jungGT/rgbtime/hardware/rgbtime.kicad_pcb

## KiCad design hardware/rgbtime.kicad_pcb (2015-07-12)

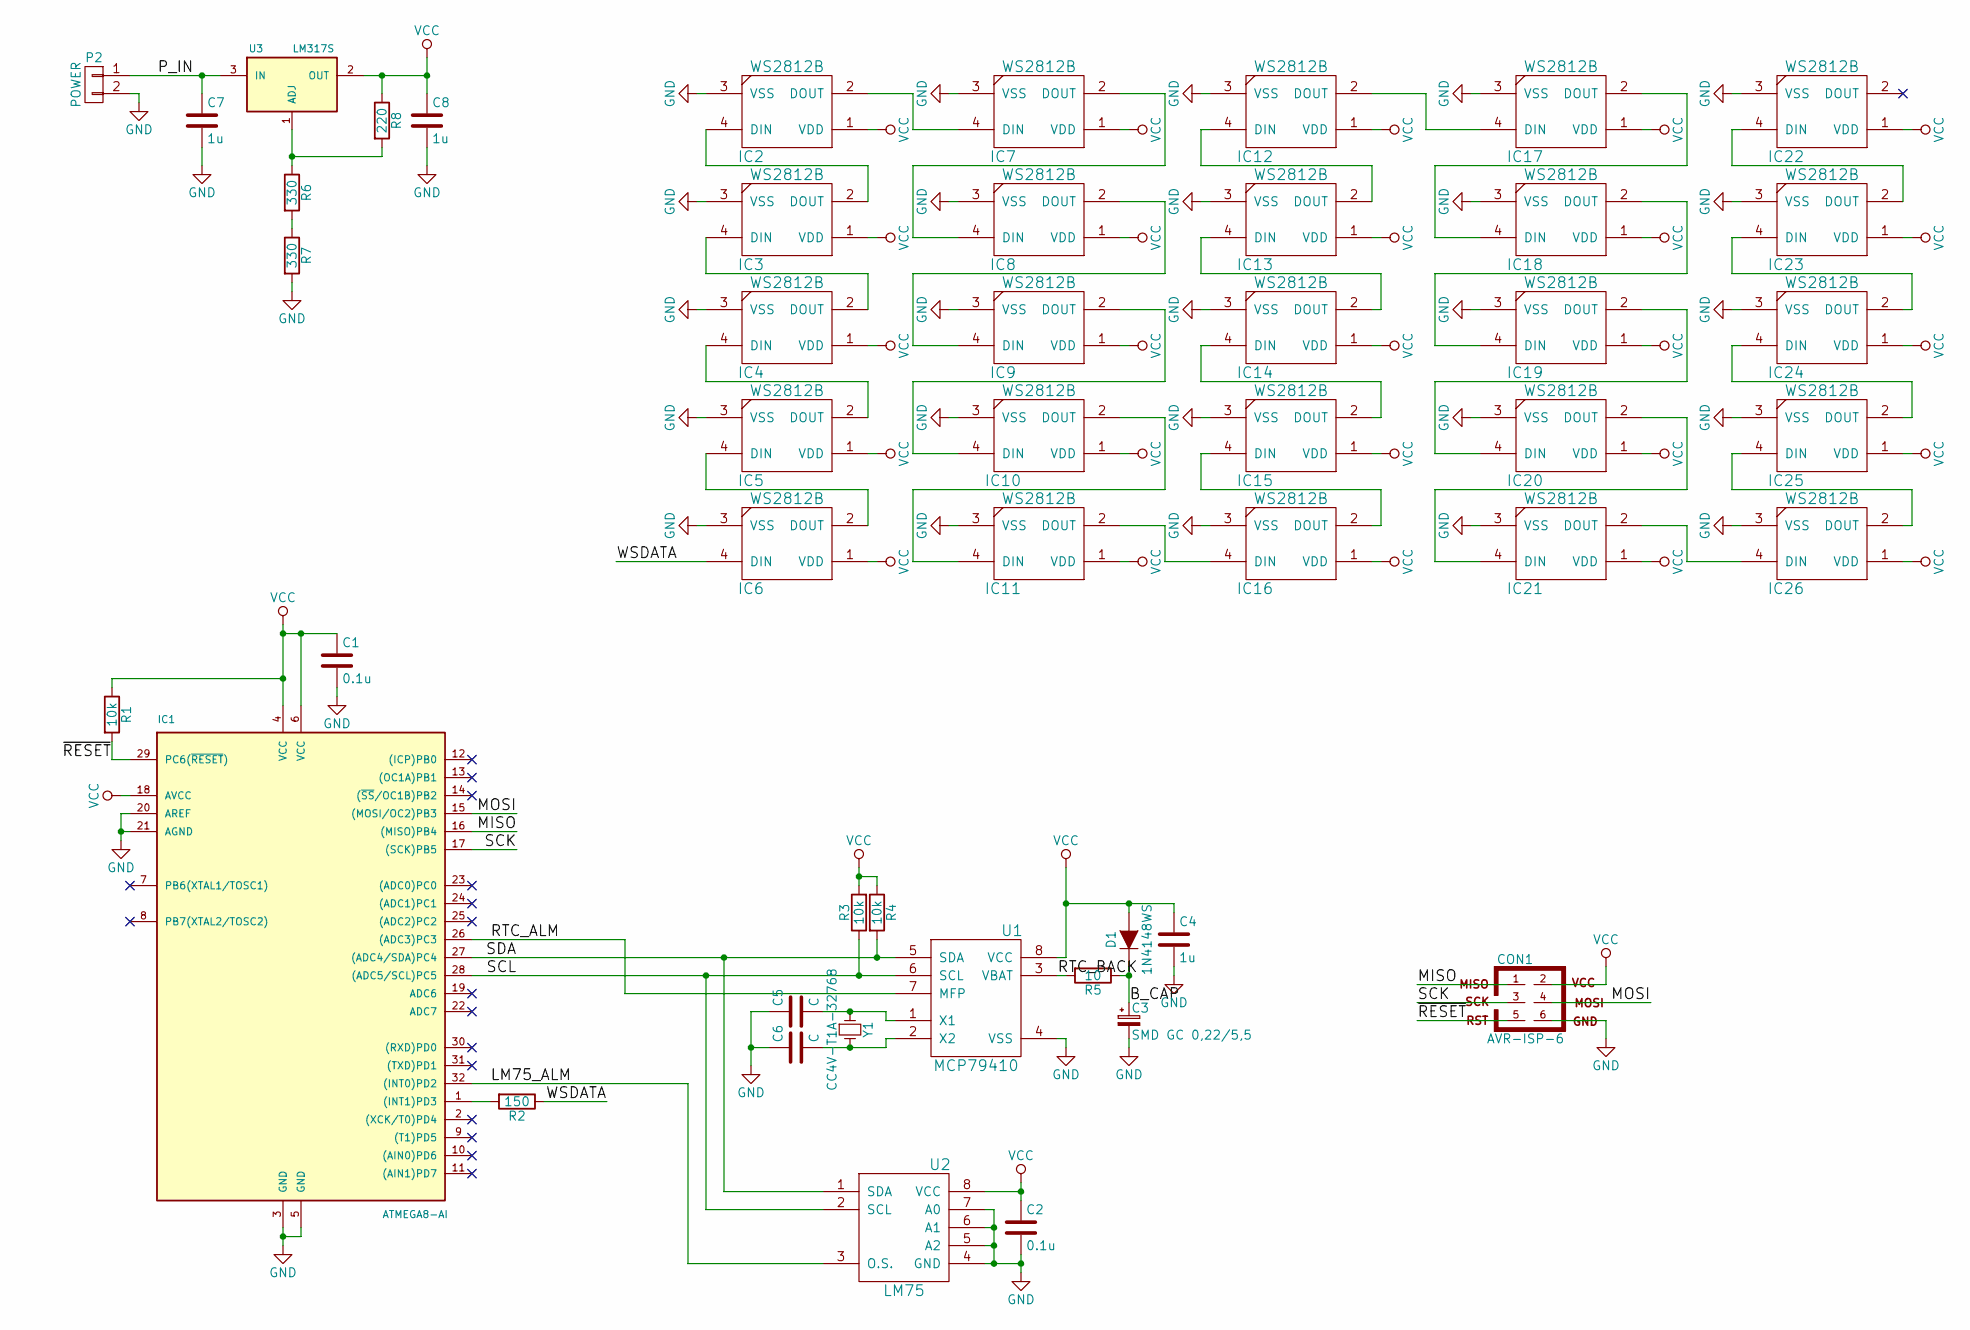
[picture p1: schematic rgbtime.sch]

Parts:
C1, C2: 0.1u; C_0603_HandSoldering
C3: SMD GC 0,22/5,5; c_elec_8x10.5
C4, C7, C8: 1u; C_0805_HandSoldering
C5, C6: C; C_0603_HandSoldering
CON1: AVR-ISP-6; Pin_Header_Straight_2x03
D1: 1N4148WS; SOD-323
IC1: ATMEGA8-AI; TQFP-32_7x7mm_Pitch0.8mm
IC2, IC3, IC4, IC5, IC6, IC7, IC8, IC9, IC10, IC11, IC12, IC13, IC14, IC15, IC16, IC17, IC18, IC19, IC20, IC21, IC22, IC23, IC24, IC25, IC26: WS2812B
P2: POWER; bornier2
R1, R3, R4: 10k; R_0603_HandSoldering
R2: 150; R_0603_HandSoldering
R5: 10; R_0603_HandSoldering
R6, R7: 330; R_0603_HandSoldering
R8: 220; R_0603_HandSoldering
U1: MCP79410; SO8
U2: LM75; SO8
U3: LM317S; TO-263
Y1: CC4V-T1A-32768; CC4V-T1A

Connections:
/B_CAP: C3.1, D1.1 (K), R5.1
/LM75_ALM: IC1.32 ((INT0)PD2), U2.3 (O.S.)
/MISO: CON1.1, IC1.16 ((MISO)PB4)
/MOSI: CON1.4, IC1.15 ((MOSI/OC2)PB3)
/P_IN: C7.1, P2.1, U3.3 (IN)
/RTC_ALM: IC1.26 ((ADC3)PC3), U1.7 (MFP)
/RTC_BACK: R5.2, U1.3 (VBAT)
/SCK: CON1.3, IC1.17 ((SCK)PB5)
/SCL: IC1.28 ((ADC5/SCL)PC5), R3.1, U1.6 (SCL), U2.2 (SCL)
/SDA: IC1.27 ((ADC4/SDA)PC4), R4.2, U1.5 (SDA), U2.1 (SDA)
/WSDATA: IC6.4 (DIN), R2.1
/~RESET: CON1.5, IC1.29 (PC6(~RESET~)), R1.2
GND: C1.2, C2.2, C3.2, C4.2, C5.1, C6.1, C7.2, C8.2, CON1.6, IC1.3 (GND), IC1.5 (GND), IC1.20 (AREF), IC1.21 (AGND), IC2.3 (VSS), IC3.3 (VSS), IC4.3 (VSS), IC5.3 (VSS), IC6.3 (VSS), IC7.3 (VSS), IC8.3 (VSS), IC9.3 (VSS), IC10.3 (VSS), IC11.3 (VSS), IC12.3 (VSS), IC13.3 (VSS), IC14.3 (VSS), IC15.3 (VSS), IC16.3 (VSS), IC17.3 (VSS), IC18.3 (VSS), IC19.3 (VSS), IC20.3 (VSS), IC21.3 (VSS), IC22.3 (VSS), IC23.3 (VSS), IC24.3 (VSS), IC25.3 (VSS), IC26.3 (VSS), P2.2, R7.2, U1.4 (VSS), U2.4 (GND), U2.5 (A2), U2.6 (A1), U2.7 (A0)
unnamed: C5.2, U1.1 (X1), Y1.1
unnamed: C6.2, U1.2 (X2), Y1.2
unnamed: IC1.1 ((INT1)PD3), R2.2
unnamed: IC2.2 (DOUT), IC7.4 (DIN)
unnamed: IC2.4 (DIN), IC3.2 (DOUT)
unnamed: IC3.4 (DIN), IC4.2 (DOUT)
unnamed: IC4.4 (DIN), IC5.2 (DOUT)
unnamed: IC5.4 (DIN), IC6.2 (DOUT)
unnamed: IC7.2 (DOUT), IC8.4 (DIN)
unnamed: IC8.2 (DOUT), IC9.4 (DIN)
unnamed: IC10.2 (DOUT), IC11.4 (DIN)
unnamed: IC9.2 (DOUT), IC10.4 (DIN)
unnamed: IC11.2 (DOUT), IC16.4 (DIN)
unnamed: IC12.2 (DOUT), IC17.4 (DIN)
unnamed: IC12.4 (DIN), IC13.2 (DOUT)
unnamed: IC13.4 (DIN), IC14.2 (DOUT)
unnamed: IC14.4 (DIN), IC15.2 (DOUT)
unnamed: IC15.4 (DIN), IC16.2 (DOUT)
unnamed: IC17.2 (DOUT), IC18.4 (DIN)
unnamed: IC18.2 (DOUT), IC19.4 (DIN)
unnamed: IC19.2 (DOUT), IC20.4 (DIN)
unnamed: IC20.2 (DOUT), IC21.4 (DIN)
unnamed: IC21.2 (DOUT), IC26.4 (DIN)
unnamed: IC22.4 (DIN), IC23.2 (DOUT)
unnamed: IC23.4 (DIN), IC24.2 (DOUT)
unnamed: IC24.4 (DIN), IC25.2 (DOUT)
unnamed: IC25.4 (DIN), IC26.2 (DOUT)
unnamed: R6.1, R8.2, U3.1 (ADJ)
unnamed: R6.2, R7.1
VCC: C1.1, C2.1, C4.1, C8.1, CON1.2, D1.2 (A), IC1.4 (VCC), IC1.6 (VCC), IC1.18 (AVCC), IC2.1 (VDD), IC3.1 (VDD), IC4.1 (VDD), IC5.1 (VDD), IC6.1 (VDD), IC7.1 (VDD), IC8.1 (VDD), IC9.1 (VDD), IC10.1 (VDD), IC11.1 (VDD), IC12.1 (VDD), IC13.1 (VDD), IC14.1 (VDD), IC15.1 (VDD), IC16.1 (VDD), IC17.1 (VDD), IC18.1 (VDD), IC19.1 (VDD), IC20.1 (VDD), IC21.1 (VDD), IC22.1 (VDD), IC23.1 (VDD), IC24.1 (VDD), IC25.1 (VDD), IC26.1 (VDD), R1.1, R3.2, R4.1, R8.1, U1.8 (VCC), U2.8 (VCC), U3.2 (OUT)

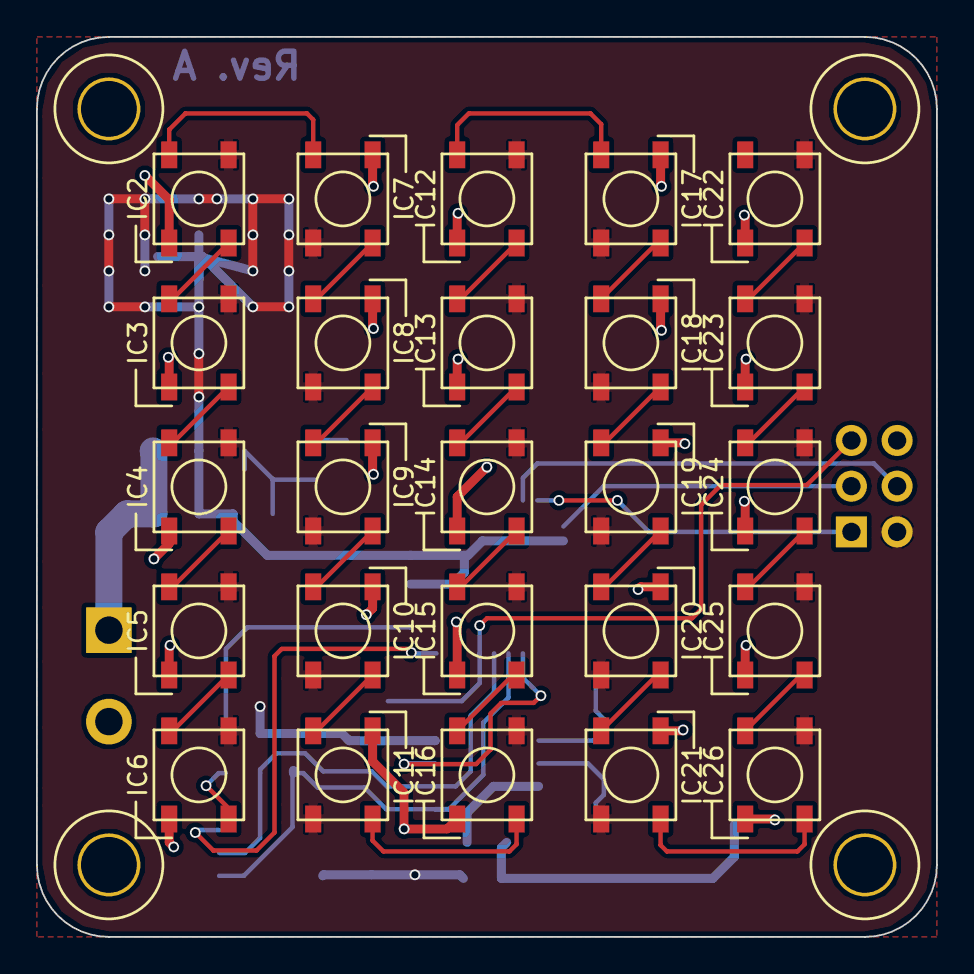
[picture p2: board rgbtime.kicad_pcb from above]

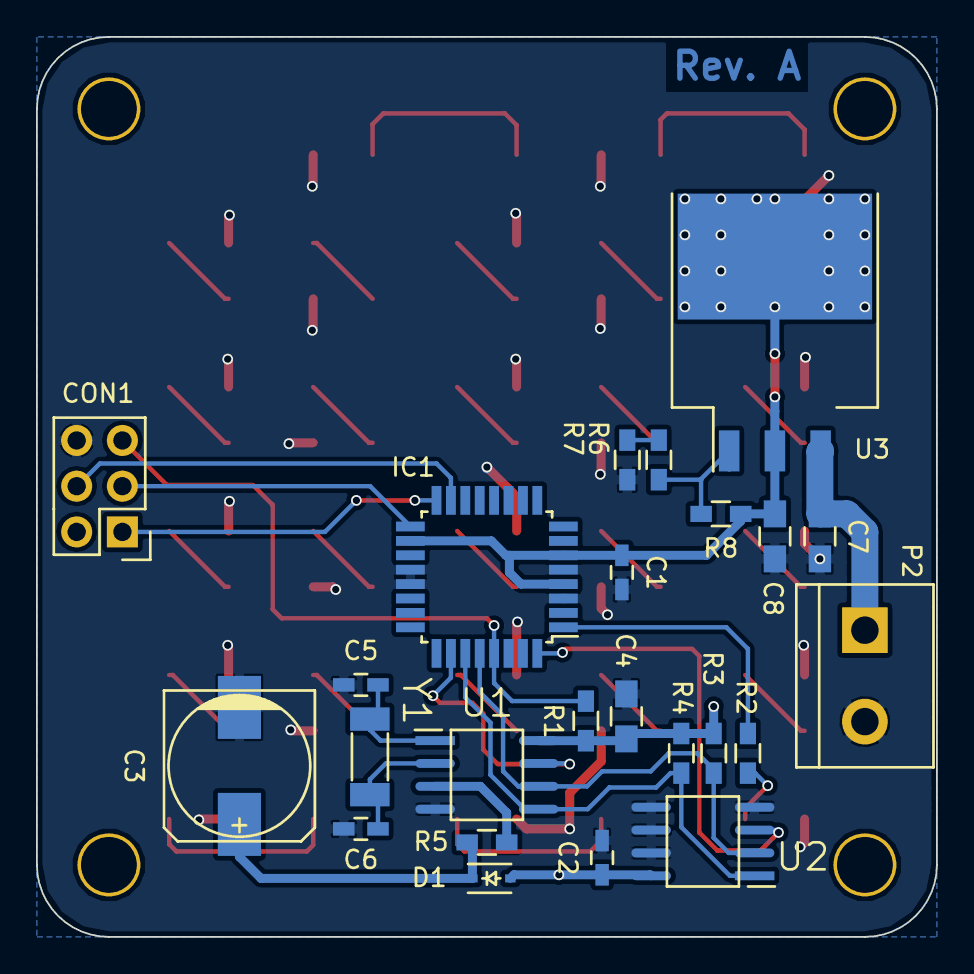
[picture p3: board rgbtime.kicad_pcb from below]

Board: 2 copper layers, 50.0 x 50.0 mm, 49 parts (24 on the bottom side), 43 nets.
