jungGT/rgbtime/firmware/rgb_lookup.h

#ifndef RGB_LOOKUP_H
#define RGB_LOOKUP_H

#include <avr/pgmspace.h>

const uint8_t rgb_lookup[360][3] PROGMEM = {
	{25,0,0},
	{25,0,0},{25,1,0},{25,1,0},{25,2,0},{25,2,0},{25,2,0},{25,3,0},{25,3,0},{25,4,0},{25,4,0},
	{25,5,0},{25,5,0},{25,5,0},{25,6,0},{25,6,0},{25,7,0},{25,7,0},{25,8,0},{25,8,0},{25,8,0},
	{25,9,0},{25,9,0},{25,10,0},{25,10,0},{25,10,0},{25,11,0},{25,11,0},{25,12,0},{25,12,0},{25,13,0},
	{25,13,0},{25,13,0},{25,14,0},{25,14,0},{25,15,0},{25,15,0},{25,15,0},{25,16,0},{25,16,0},{25,17,0},
	{25,17,0},{25,18,0},{25,18,0},{25,18,0},{25,19,0},{25,19,0},{25,20,0},{25,20,0},{25,20,0},{25,21,0},
	{25,21,0},{25,22,0},{25,22,0},{25,22,0},{25,23,0},{25,23,0},{25,24,0},{25,24,0},{25,25,0},{25,25,0},
	{25,25,0},{24,25,0},{24,25,0},{23,25,0},{23,25,0},{22,25,0},{22,25,0},{22,25,0},{21,25,0},{21,25,0},
	{20,25,0},{20,25,0},{20,25,0},{19,25,0},{19,25,0},{18,25,0},{18,25,0},{18,25,0},{17,25,0},{17,25,0},
	{16,25,0},{16,25,0},{15,25,0},{15,25,0},{15,25,0},{14,25,0},{14,25,0},{13,25,0},{13,25,0},{13,25,0},
	{12,25,0},{12,25,0},{11,25,0},{11,25,0},{10,25,0},{10,25,0},{10,25,0},{9,25,0},{9,25,0},{8,25,0},
	{8,25,0},{8,25,0},{7,25,0},{7,25,0},{6,25,0},{6,25,0},{5,25,0},{5,25,0},{5,25,0},{4,25,0},
	{4,25,0},{3,25,0},{3,25,0},{3,25,0},{2,25,0},{2,25,0},{1,25,0},{1,25,0},{0,25,0},{0,25,0},
	{0,25,0},{0,25,1},{0,25,1},{0,25,2},{0,25,2},{0,25,3},{0,25,3},{0,25,3},{0,25,4},{0,25,4},
	{0,25,5},{0,25,5},{0,25,5},{0,25,6},{0,25,6},{0,25,7},{0,25,7},{0,25,8},{0,25,8},{0,25,8},
	{0,25,9},{0,25,9},{0,25,10},{0,25,10},{0,25,10},{0,25,11},{0,25,11},{0,25,12},{0,25,12},{0,25,13},
	{0,25,13},{0,25,13},{0,25,14},{0,25,14},{0,25,15},{0,25,15},{0,25,15},{0,25,16},{0,25,16},{0,25,17},
	{0,25,17},{0,25,18},{0,25,18},{0,25,18},{0,25,19},{0,25,19},{0,25,20},{0,25,20},{0,25,20},{0,25,21},
	{0,25,21},{0,25,22},{0,25,22},{0,25,22},{0,25,23},{0,25,23},{0,25,24},{0,25,24},{0,25,25},{0,25,25},
	{0,25,25},{0,24,25},{0,24,25},{0,23,25},{0,23,25},{0,22,25},{0,22,25},{0,22,25},{0,21,25},{0,21,25},
	{0,20,25},{0,20,25},{0,20,25},{0,19,25},{0,19,25},{0,18,25},{0,18,25},{0,17,25},{0,17,25},{0,17,25},
	{0,16,25},{0,16,25},{0,15,25},{0,15,25},{0,15,25},{0,14,25},{0,14,25},{0,13,25},{0,13,25},{0,13,25},
	{0,12,25},{0,12,25},{0,11,25},{0,11,25},{0,10,25},{0,10,25},{0,10,25},{0,9,25},{0,9,25},{0,8,25},
	{0,8,25},{0,7,25},{0,7,25},{0,7,25},{0,6,25},{0,6,25},{0,5,25},{0,5,25},{0,5,25},{0,4,25},
	{0,4,25},{0,3,25},{0,3,25},{0,2,25},{0,2,25},{0,2,25},{0,1,25},{0,1,25},{0,0,25},{0,0,25},
	{0,0,25},{1,0,25},{1,0,25},{2,0,25},{2,0,25},{2,0,25},{3,0,25},{3,0,25},{4,0,25},{4,0,25},
	{5,0,25},{5,0,25},{5,0,25},{6,0,25},{6,0,25},{7,0,25},{7,0,25},{7,0,25},{8,0,25},{8,0,25},
	{9,0,25},{9,0,25},{10,0,25},{10,0,25},{10,0,25},{11,0,25},{11,0,25},{12,0,25},{12,0,25},{13,0,25},
	{13,0,25},{13,0,25},{14,0,25},{14,0,25},{15,0,25},{15,0,25},{15,0,25},{16,0,25},{16,0,25},{17,0,25},
	{17,0,25},{18,0,25},{18,0,25},{18,0,25},{19,0,25},{19,0,25},{20,0,25},{20,0,25},{20,0,25},{21,0,25},
	{21,0,25},{22,0,25},{22,0,25},{23,0,25},{23,0,25},{23,0,25},{24,0,25},{24,0,25},{25,0,25},{25,0,25},
	{25,0,25},{25,0,24},{25,0,24},{25,0,23},{25,0,23},{25,0,23},{25,0,22},{25,0,22},{25,0,21},{25,0,21},
	{25,0,20},{25,0,20},{25,0,20},{25,0,19},{25,0,19},{25,0,18},{25,0,18},{25,0,17},{25,0,17},{25,0,17},
	{25,0,16},{25,0,16},{25,0,15},{25,0,15},{25,0,15},{25,0,14},{25,0,14},{25,0,13},{25,0,13},{25,0,13},
	{25,0,12},{25,0,12},{25,0,11},{25,0,11},{25,0,10},{25,0,10},{25,0,10},{25,0,9},{25,0,9},{25,0,8},
	{25,0,8},{25,0,7},{25,0,7},{25,0,7},{25,0,6},{25,0,6},{25,0,5},{25,0,5},{25,0,5},{25,0,4},
	{25,0,4},{25,0,3},{25,0,3},{25,0,2},{25,0,2},{25,0,2},{25,0,1},{25,0,1},{25,0,0},
};
#endif
