jungGT/rgbtime/(commit log)

2015-07-09 initial commit, missing USB footprint
    [rgbtime.kicad_pcb, rgbtime.sch]
2015-07-09 started layout, matrix placed, need USB footprint
    [rgbtime.kicad_pcb, rgbtime.sch]
2015-07-10 restructured repo
    [rgbtime.kicad_pcb, rgbtime.sch]
2015-07-11 added LM75 temperature sensor readout
2015-07-12 fixed signed int cast
    [lm75_temp.c]
2015-07-12 final hardware revision A done, sent to fab
    [rgbtime.kicad_pcb, rgbtime.sch]
2015-08-21 fixed timing, new color lookup
    [main.c, rgb_lookup.h, ws2812.c]
2015-08-29 fixed time reset issues
    [main.c, pixgraph.c, pixgraph.h, rtc.c]
2015-09-02 added correct time display and set initial time
    [main.c, rtc.c, rtc.h]
